elektronomikon/raspi_gpib_shield/README.md

# raspi_gpib_shield
A GPIB shield for the raspberry pi.

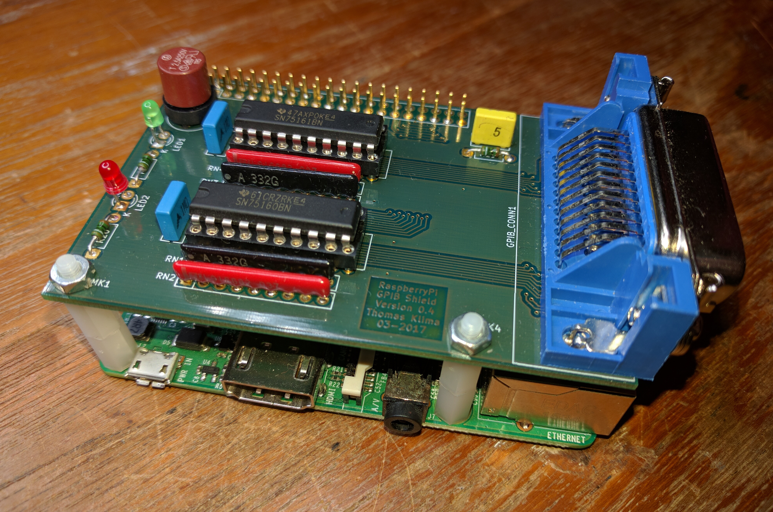
[picture p1: Documentation/RasPi GPIB Shield V0.4.jpg]
RasPi GPIB Shield V0.4 Foto


Connecting GPIB-capable lab equipment to your PC nowadays is mostly a choice between several USB-to-GPIB adapters. If your platform of choice is linux, especially the Raspberry Pi, then you may run into trouble getting some of the proprietary adapters up and running.

The Raspberry Pi shield was created to solve this problem.

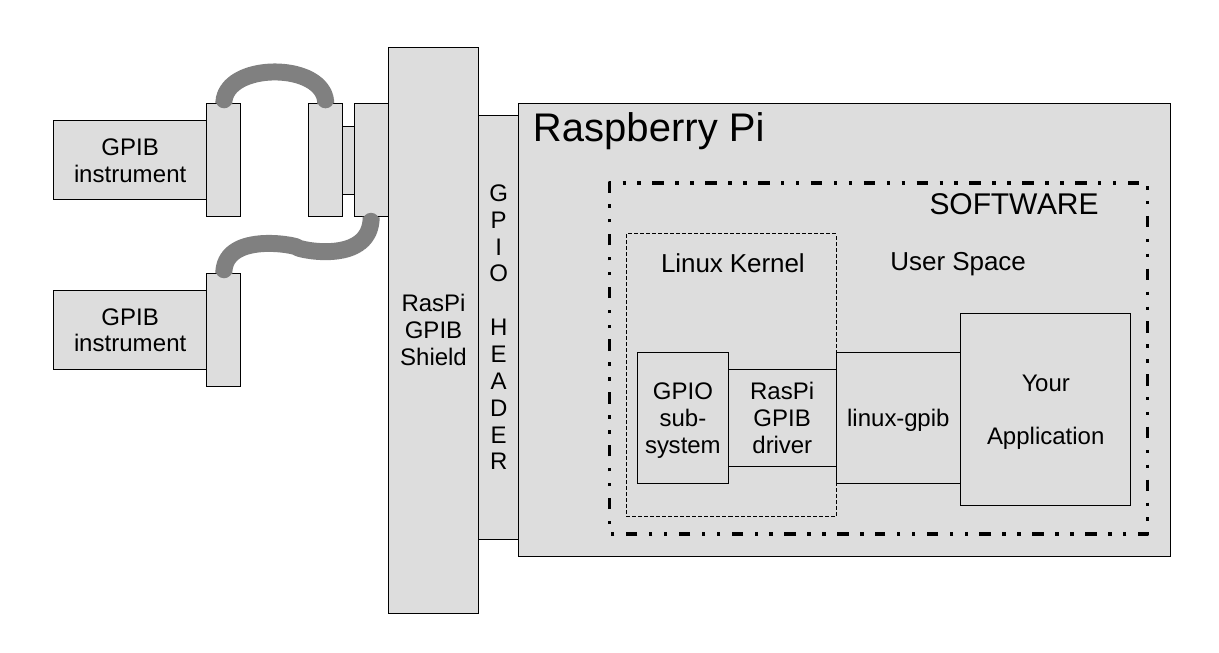
[picture p2: Documentation/Overview.png]
RasPi_GPIB_Shield Overview


This repository only contains the schematics for the raspberry-pi GPIB shield, which is meant to be used with the gpib_bitbang driver from linux-gpib.

Copy or clone to a local folder to view in KiCad, a pdf of the schematic is found under /documentation/.

For preassembled units please contact us at elektronomikon@gmail.com, further infos at https://elektronomikon.org
