elektronomikon/raspi_gpib_shield/Documentation/Raspi_GPIB_V6 PCB render.png

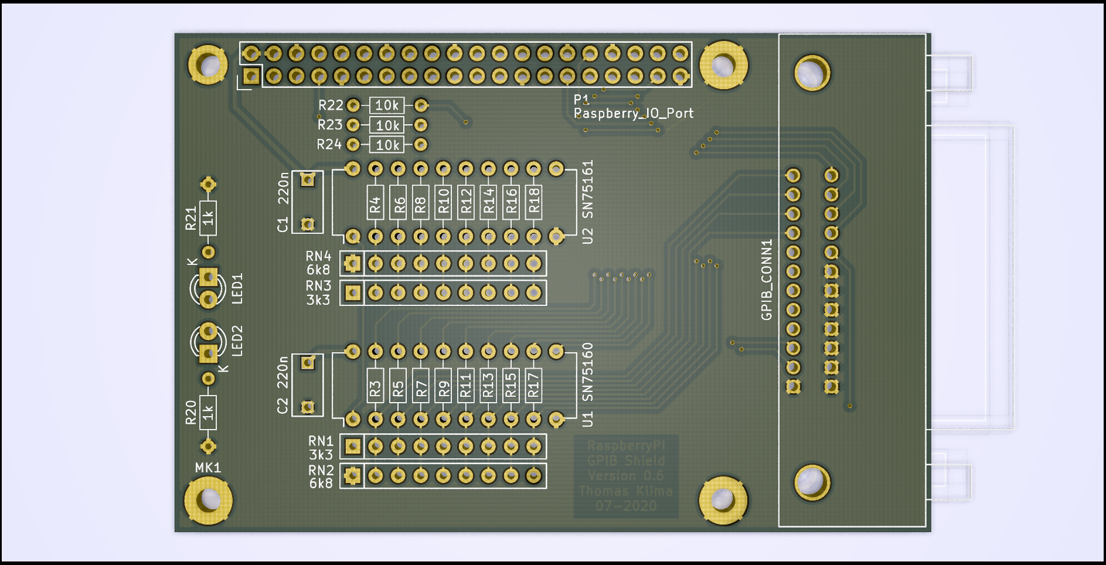
Documentation/Raspi_GPIB_V6 PCB render.png
