elektronomikon/raspi_gpib_shield/Documentation/Raspi_GPIB_V6.pdf

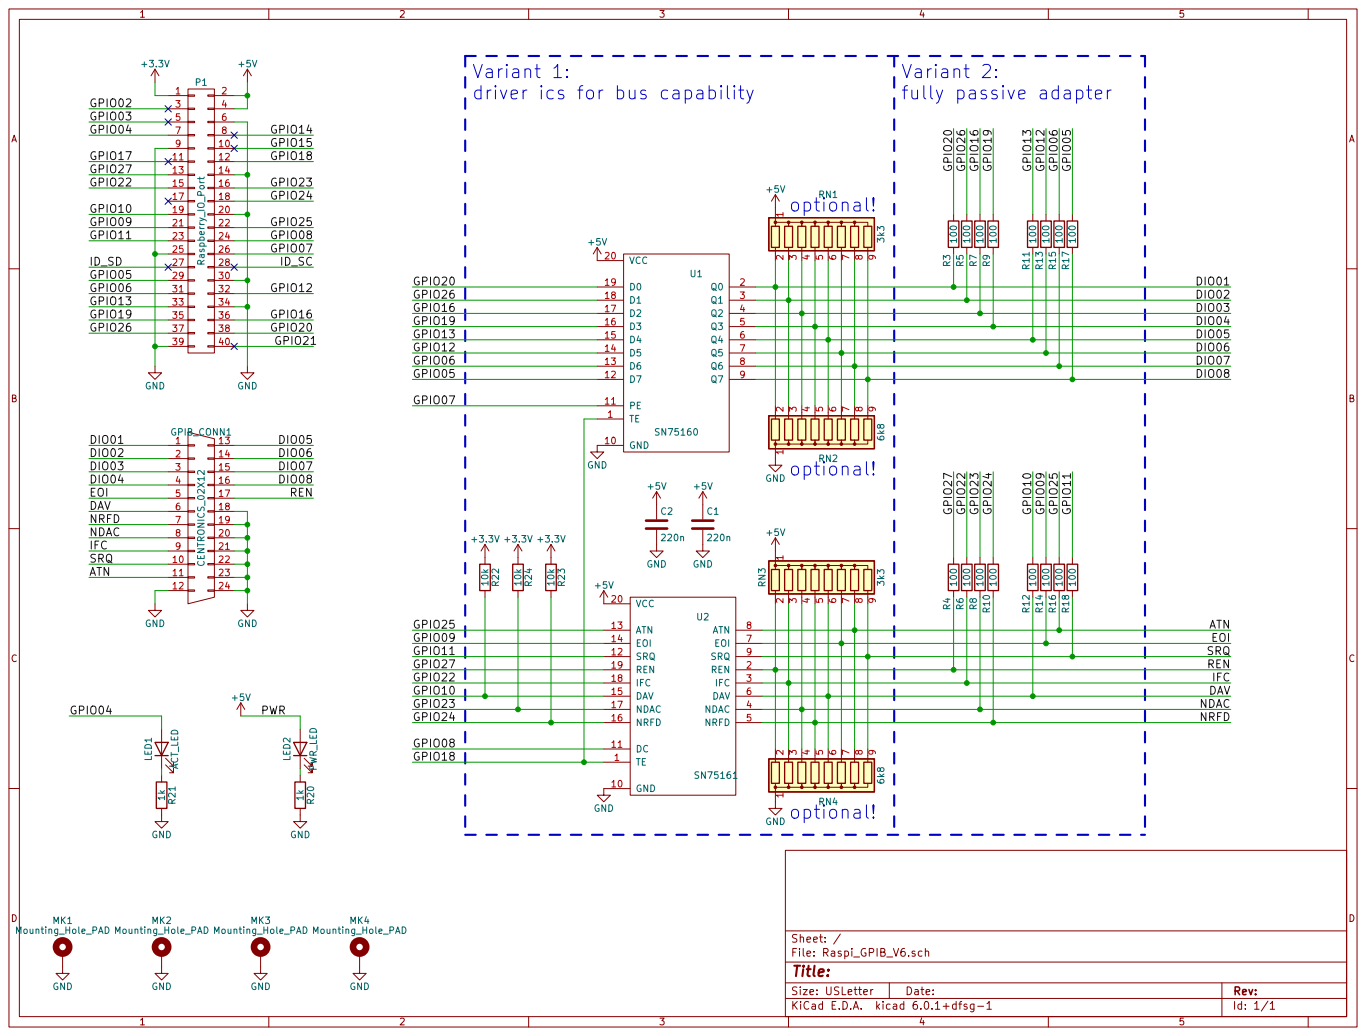
[picture p4: page 1]

Variant 1:
driver ics for bus capability

29
31 | 32 34
33
