elektronomikon/raspi_gpib_shield/Documentation/RPi_GPIB_Shield.pdf

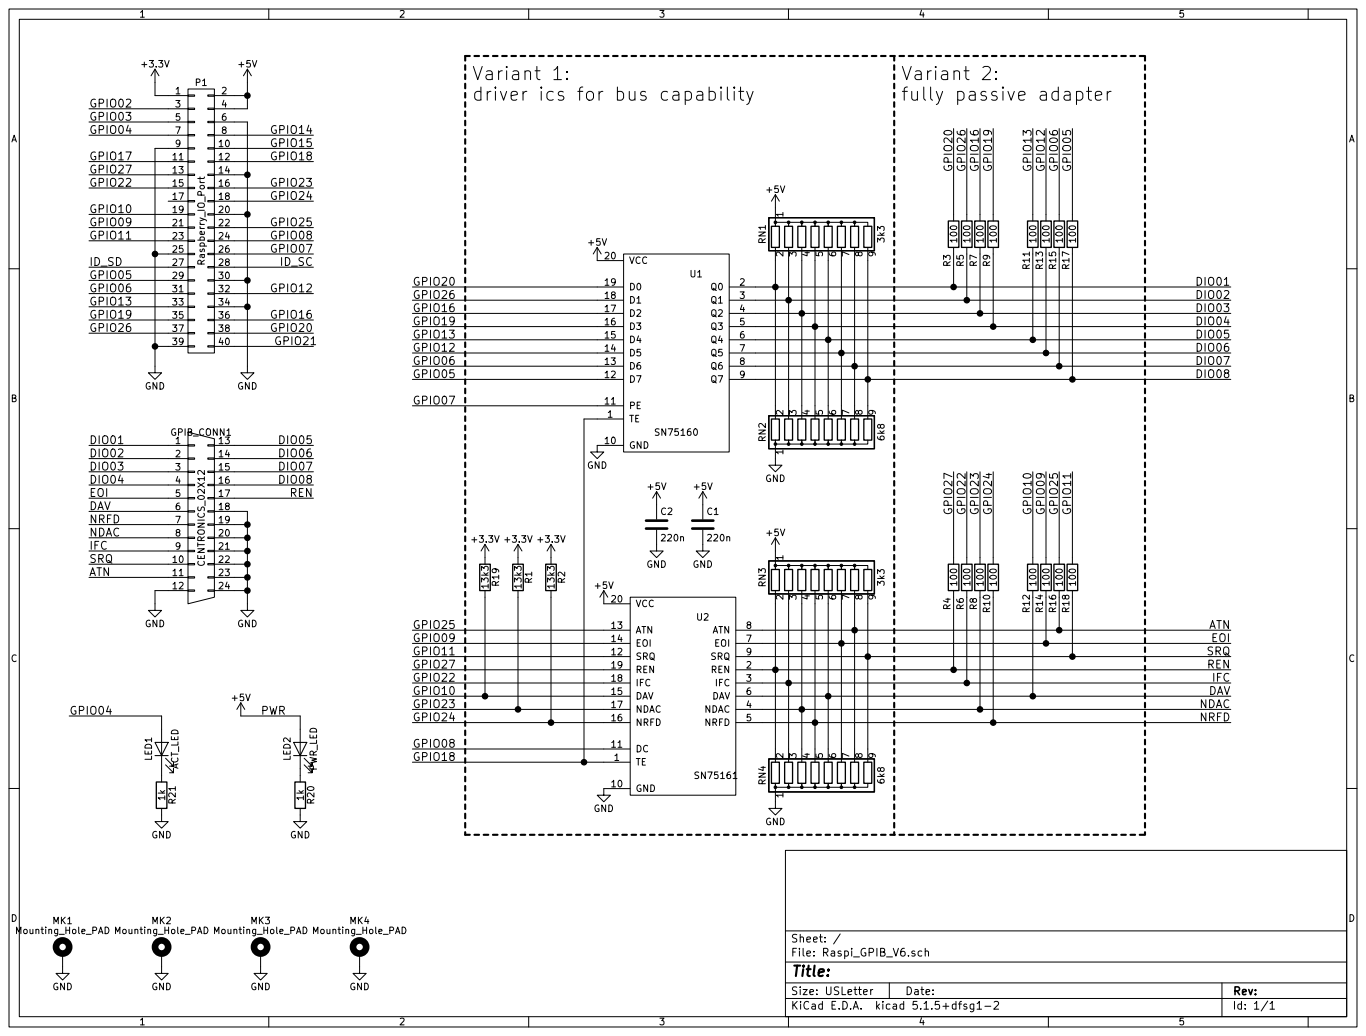
[picture p5: page 1]

9 RN3 3k3 GND 10 VCC 20 TE 1 Q0 2 Q1 3 Q2 4 Q3 5 Q4 6 Q5 7 Q6 8 Q7 9 PE 11 D7 12 D6 13 D5 14 D4 15 D3 16 D2 17 D1 18 D0 19 U1 SN75160 +3.3V +5V 13k3 R19 +3.3V GND GND GPIO19

Variant 1:
driver ics for bus capability

+5V | Variant 2:

7 | 8 12 14

13
15 | 16 18 20

21 | 22 24 26 28 30
23

9 RN1 3k3 R17 100 R15 100 R13 100 R11 100 R9 100 R7 100 R5 100 R3 100 R18 100 R16 100 R14 100 R12 100 R10 100 GND 10 VCC 20 TE 1 REN 2

29
31 | 32 34
33
35
37
