elektronomikon/raspi_gpib_shield/Raspi_GPIB_V6.sch

## KiCad design Raspi_GPIB_V6.sch (2021-05-20)

Schematic: Raspi_GPIB_V6.sch

Parts:
C1, C2: 220n; C_Rect_L7_W3.5_P5
GPIB_CONN1: CENTRONICS_02X12; Centronics_24pin_Through_hole
LED1: ACT_LED; LED-3MM
LED2: PWR_LED; LED-3MM
MK1, MK2, MK3, MK4: Mounting_Hole_PAD; MountingHole_2.7mm_M2.5_Pad
P1: Raspberry_IO_Port; Pin_Header_Straight_2x20
R3, R4, R5, R6, R7, R8, R9, R10, R11, R12, R13, R14, R15, R16, R17, R18: 100; R_Axial_DIN0204_L3.6mm_D1.6mm_P7.62mm_Horizontal
R20, R21: 1k; R_Axial_DIN0204_L3.6mm_D1.6mm_P7.62mm_Horizontal
R22, R23, R24: 10k; R_Axial_DIN0204_L3.6mm_D1.6mm_P7.62mm_Horizontal
RN1, RN3: 3k3; Resistor_Array_SIP9
RN2, RN4: 6k8; Resistor_Array_SIP9
U1: SN75160; DIP-20_W7.62mm
U2: SN75161; DIP-20_W7.62mm

Notes on the sheet:
Variant 2: fully passive adapter
Variant 1: driver ics for bus capability
optional!
