elektronomikon/raspi_gpib_shield/(threads)

Thread 1 (2020-09-21):

Should I add R19 to a v0.5 board?

thomasw-mitutoyo-ctl, 2020-09-21:
I have bought a shield and I got version v0.5. It does not have R19 like [v0.6](https://github.com/elektronomikon/raspi_gpib_shield/blob/master/Documentation/RasPi%20GPIB%20Shield%20V0.6.png).

Is it recommended to add R19?

elektronomikon, 2020-09-21:
Hi,

adding R19 should not have an impact on the connection with standard compliant devices as it acts as a pull-up on the DAV line which should be driven by the talker.

Thank you for bringing this up, it will be removed in the next version ...

have fun,
Thomas

Closed 2020-09-21.

Thread 2 (2020-09-21):

Silkscreen issues on board v0.5

thomasw-mitutoyo-ctl, 2020-09-21:
The silkscreen of board v0.5 could be improved:

* The component numbers of the resistor networks are positioned in places where holes overlap (marked in red). It's hard to figure out which one is which.
* The ICs should have an indicator for the placement (marked in red)
* The GPIO header is supposed to be placed from the bottom, so its silk screen should be on the bottom, too (marked blue)
* IMHO, the mounting holes do not necessarily need a silk screen. But if they have, I'd prefer a readable silk screen for all of them, not only MK4.
* Resistors R3 .. R18 might have the label inside the component instead of overlapping with the next resistor

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

From the photo for v0.4, it seems the silk screen was better.

elektronomikon, 2020-09-21:
Hi,

i absolutely agree, all labels and values are now readable in V.6 - just a mounting hole label snuck in ;-)

Thanks for the hint w.r.t the nose on U1 and U2, totally missed those.

If you want to take a look at V.6, it looks like this:
[https://github.com/elektronomikon/raspi_gpib_shield/raw/master/Documentation/Raspi_GPIB_V6%20PCB%20render.png](https://github.com/elektronomikon/raspi_gpib_shield/raw/master/Documentation/Raspi_GPIB_V6%20PCB%20render.png)

In closing, the next version should probably feature:
-) A RasPi Port label which is not riddled with holes from vias
-) Sane numbers on the resistor labels
-) RN1/2 or RN3/4 swapped for symmetry
-) PWR/ACT instead of LED1/2
-) No MK1 label
-) Directional indicators on U1/2

Thank you very much for your time!

have fun,
Thomas

thomasw-mitutoyo-ctl, 2020-09-21:
Thanks, v0.6 looks great.

Closed 2020-09-21.

Thread 3 (2020-09-22):

Assembling instructions: getting the GPIO header right

thomasw-mitutoyo-ctl, 2020-09-22:
We received some short assembling instructions with the hardware kit, telling which components to be soldered for the active or passive version. Maybe you could add a short note on how to assemble the GPIO header in correct length. Basically:

1. Put the spacers onto the RPi
2. Fit the GPIO connector onto the RPi
3. Place the PCB onto the spacers
4. Solder the GPIO connector while having the correct distance

Solder the GPIO header when having it in this position:

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

If not done this way, chances are that the length is too short, spacers cannot be used and GPIB_CONN1 likely creates a short circuit on the metallic USB ports of the RPi.

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

When done wrong, desoldering the 40 pin header is painful...

elektronomikon, 2021-05-20:
Hi,
thanks for the input - i extended the assembly instructions accordingly.
have fun,
Thomas

Thread 4 (2021-12-03):

ID_SD ID_SC Connections

scentedcandle42, 2021-12-03:
These connections (viewed on the pdf schematic) do not appear to connect anywhere on the schematic. Is this correct?

[https://github.com/elektronomikon/raspi_gpib_shield/blob/master/Documentation/RPi_GPIB_Shield.pdf]

elektronomikon, 2021-12-12:
Hi,

Yes, this is correct.

ID_SD and ID_SC are I²C Bus 0, used internally on the RaspberryPi. They are generally marked as reserved, so that a custom hat does not interfere with the booting process.

have fun,
Thomas

Closed 2021-12-12.

Thread 5 (2022-02-14):

Schematic PDF out of date

WhatIsTheFrequency, 2022-02-14:
R19, R1 and R2 are shown on the PDF but have been replaced by R22, R24 and R23 in version 0.6.

The out of date PDF was also sent with the assembly instructions for the kit of parts.

elektronomikon, 2022-02-14:
Thank you very much for the heads up!

Please see the updated version:
https://github.com/elektronomikon/raspi_gpib_shield/blob/76772e7b8017ecd45feb5491619b0a94da0672b7/Documentation/Raspi_GPIB_V6.pdf

have fun,
Thomas

Closed 2022-02-14.
