elektronomikon/raspi_gpib_shield/(commit log)

2017-04-27 Initial commit, Kicad 4.0.5
    [RPi_GPIB_Shield.sch]
2017-04-27 Plot of the schematics
2017-04-27 Update README.md
    Add driver link
2020-06-17 Update RPi_GPIB_Shield.pdf
    (new symbol for GPIB connector)
2021-05-20 Update to Version 0.6
    [RPi_GPIB_Shield.sch, Raspi_GPIB_V6.sch]
